tzshin/EjectionBuddy/ejectedbuddy.png

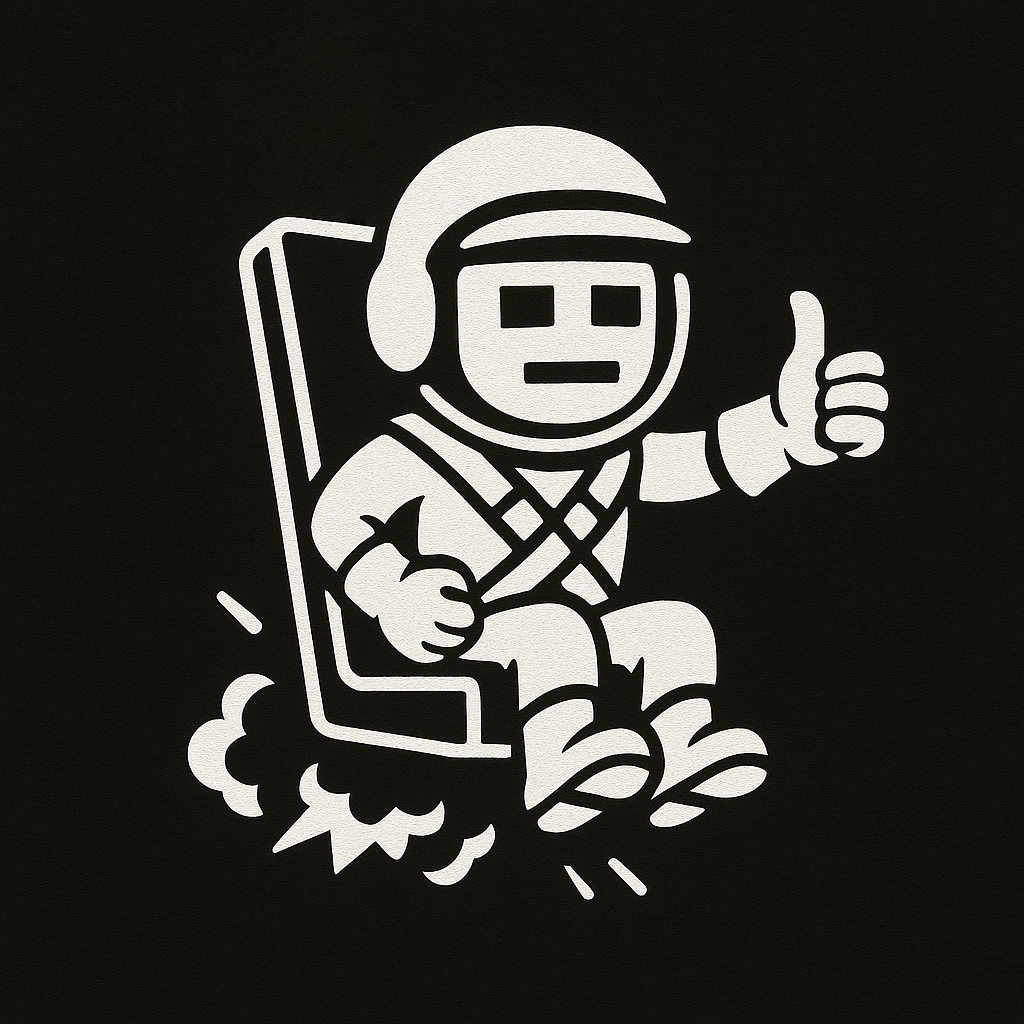
ejectedbuddy.png
