tzshin/EjectionBuddy/link.png

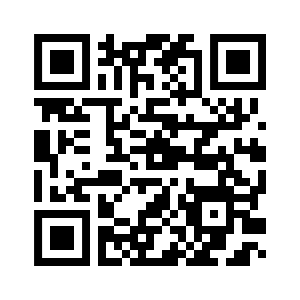
link.png
