tzshin/EjectionBuddy/kicad_libs/LM66200DRLR/LM66200DRLR.stp

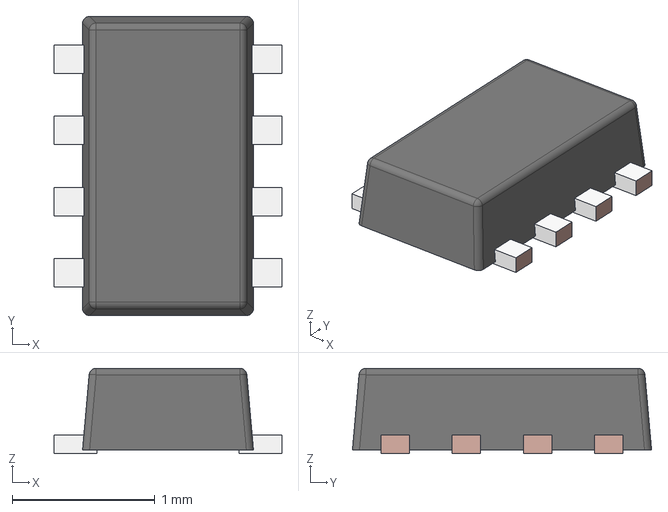
[picture p3: CAD file, 2025-04-03]
kicad_libs/LM66200DRLR/LM66200DRLR.stp
1.60 x 2.10 x 0.6 mm
FRAME-DRL0008A
BODY-SOT
