tzshin/EjectionBuddy/EjectionBuddy/EjectionBuddy.kicad_pcb

## KiCad design EjectionBuddy/EjectionBuddy.kicad_pcb (2025-04-20)

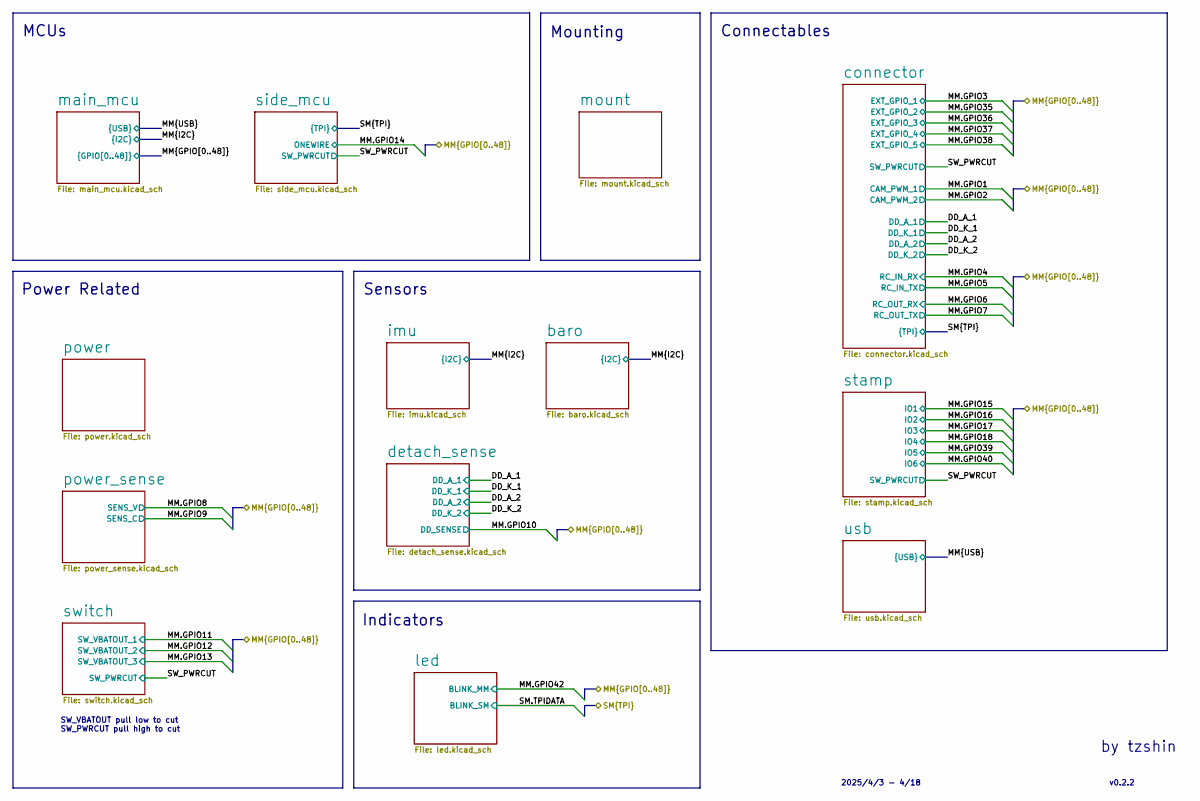
[picture p4: schematic EjectionBuddy.kicad_sch]

Notes on the sheet:
MCUs
Mounting
Sensors
v0.2.2
SW_VBATOUT pull low to cut SW_PWRCUT pull high to cut
2025/4/3 - 4/18
by tzshin
Connectables
Power Related
Indicators

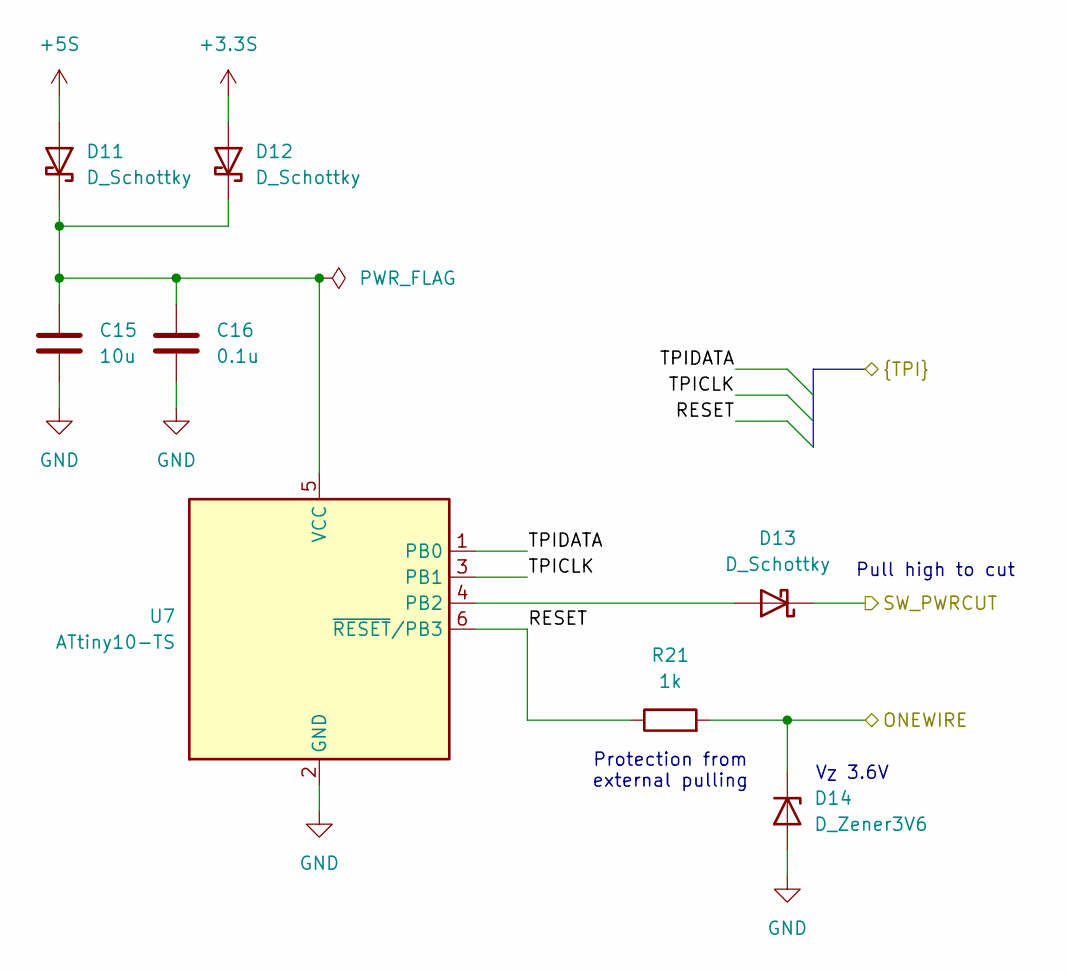
[picture p5: schematic side_mcu.kicad_sch]

Parts:
C15: 10u; C_0603_1608Metric
C16: 0.1u; C_0603_1608Metric
D11, D12, D13: D_Schottky; D_SOD-523
D14: D_Zener3V6; D_SOD-523
R21: 1k; R_0603_1608Metric
U7: ATtiny10-TS; SOT-23-6

Connections:
+3.3S: D12.2 (A); also elsewhere on the board
+5S: D11.2 (A); also elsewhere on the board
/MM.GPIO14: D14.1 (K), R21.2; also elsewhere on the board
/SM.RESET: R21.1, U7.6 (~RESET/PB3); also elsewhere on the board
/SM.TPICLK: U7.3 (PB1); also elsewhere on the board
/SM.TPIDATA: U7.1 (PB0); also elsewhere on the board
/SW_PWRCUT: D13.1 (K); also elsewhere on the board
GND: C15.2, C16.2, D14.2 (A), U7.2 (GND); also elsewhere on the board
unnamed: C15.1, C16.1, D11.1 (K), D12.1 (K), U7.5 (VCC)
unnamed: D13.2 (A), U7.4 (PB2)

Notes on the sheet:
Protection from external pulling
V_{Z} 3.6V
Pull high to cut

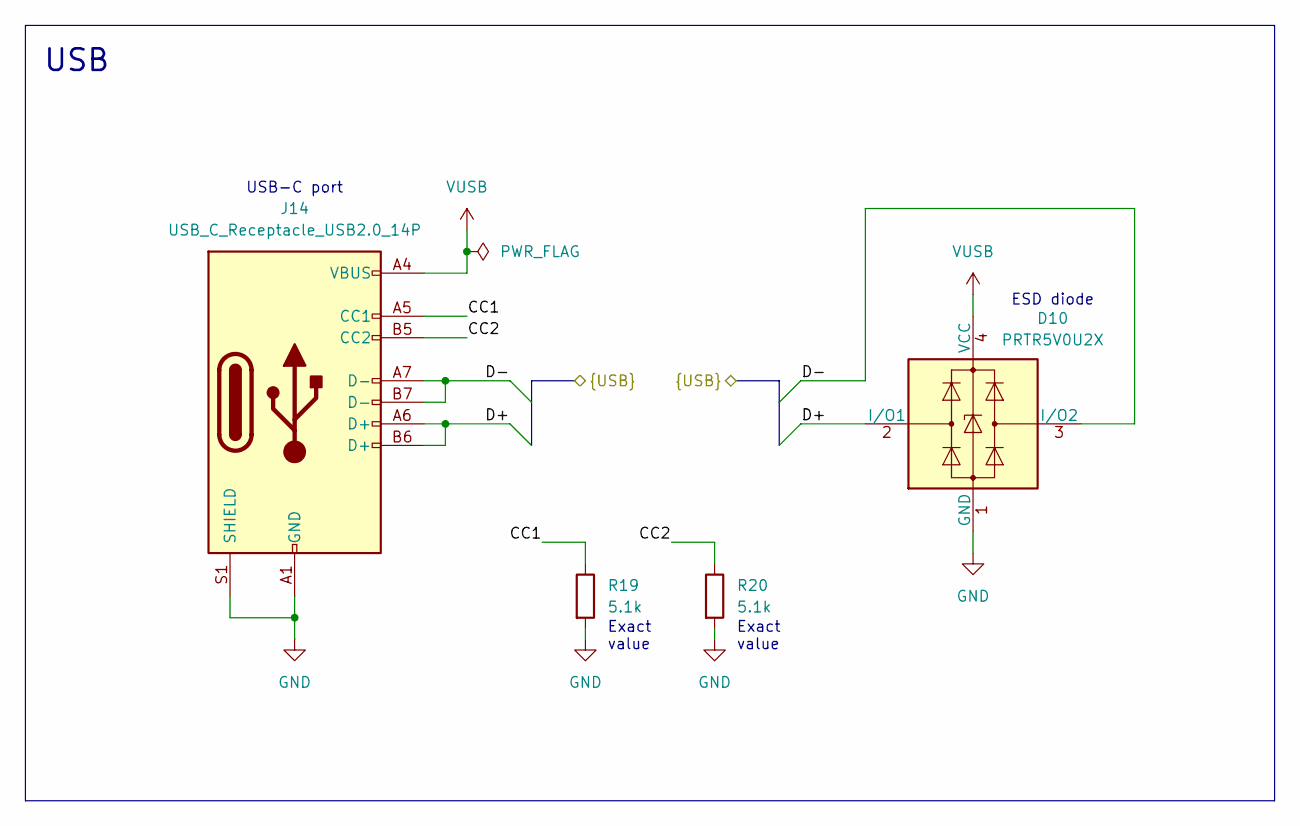
[picture p6: schematic usb.kicad_sch]

Parts:
D10: PRTR5V0U2X; SOT-143
J14: USB_C_Receptacle_USB2.0_14P; USB_C_Receptacle_HRO_TYPE-C-31-M-12
R19, R20: 5.1k; R_0603_1608Metric

Connections:
/MM.D+: D10.2 (I/O1), J14.A6 (D+), J14.B6 (D+); also elsewhere on the board
/MM.D-: D10.3 (I/O2), J14.A7 (D-), J14.B7 (D-); also elsewhere on the board
/usb/CC1: J14.A5 (CC1), R19.1
/usb/CC2: J14.B5 (CC2), R20.1
GND: D10.1 (GND), J14.A1 (GND), J14.A12 (GND), J14.B1 (GND), J14.B12 (GND), J14.S1 (SHIELD), R19.2, R20.2; also elsewhere on the board
VUSB: D10.4 (VCC), J14.A4 (VBUS), J14.A9 (VBUS), J14.B4 (VBUS), J14.B9 (VBUS); also elsewhere on the board

Notes on the sheet:
USB-C port
Exact value
USB
ESD diode

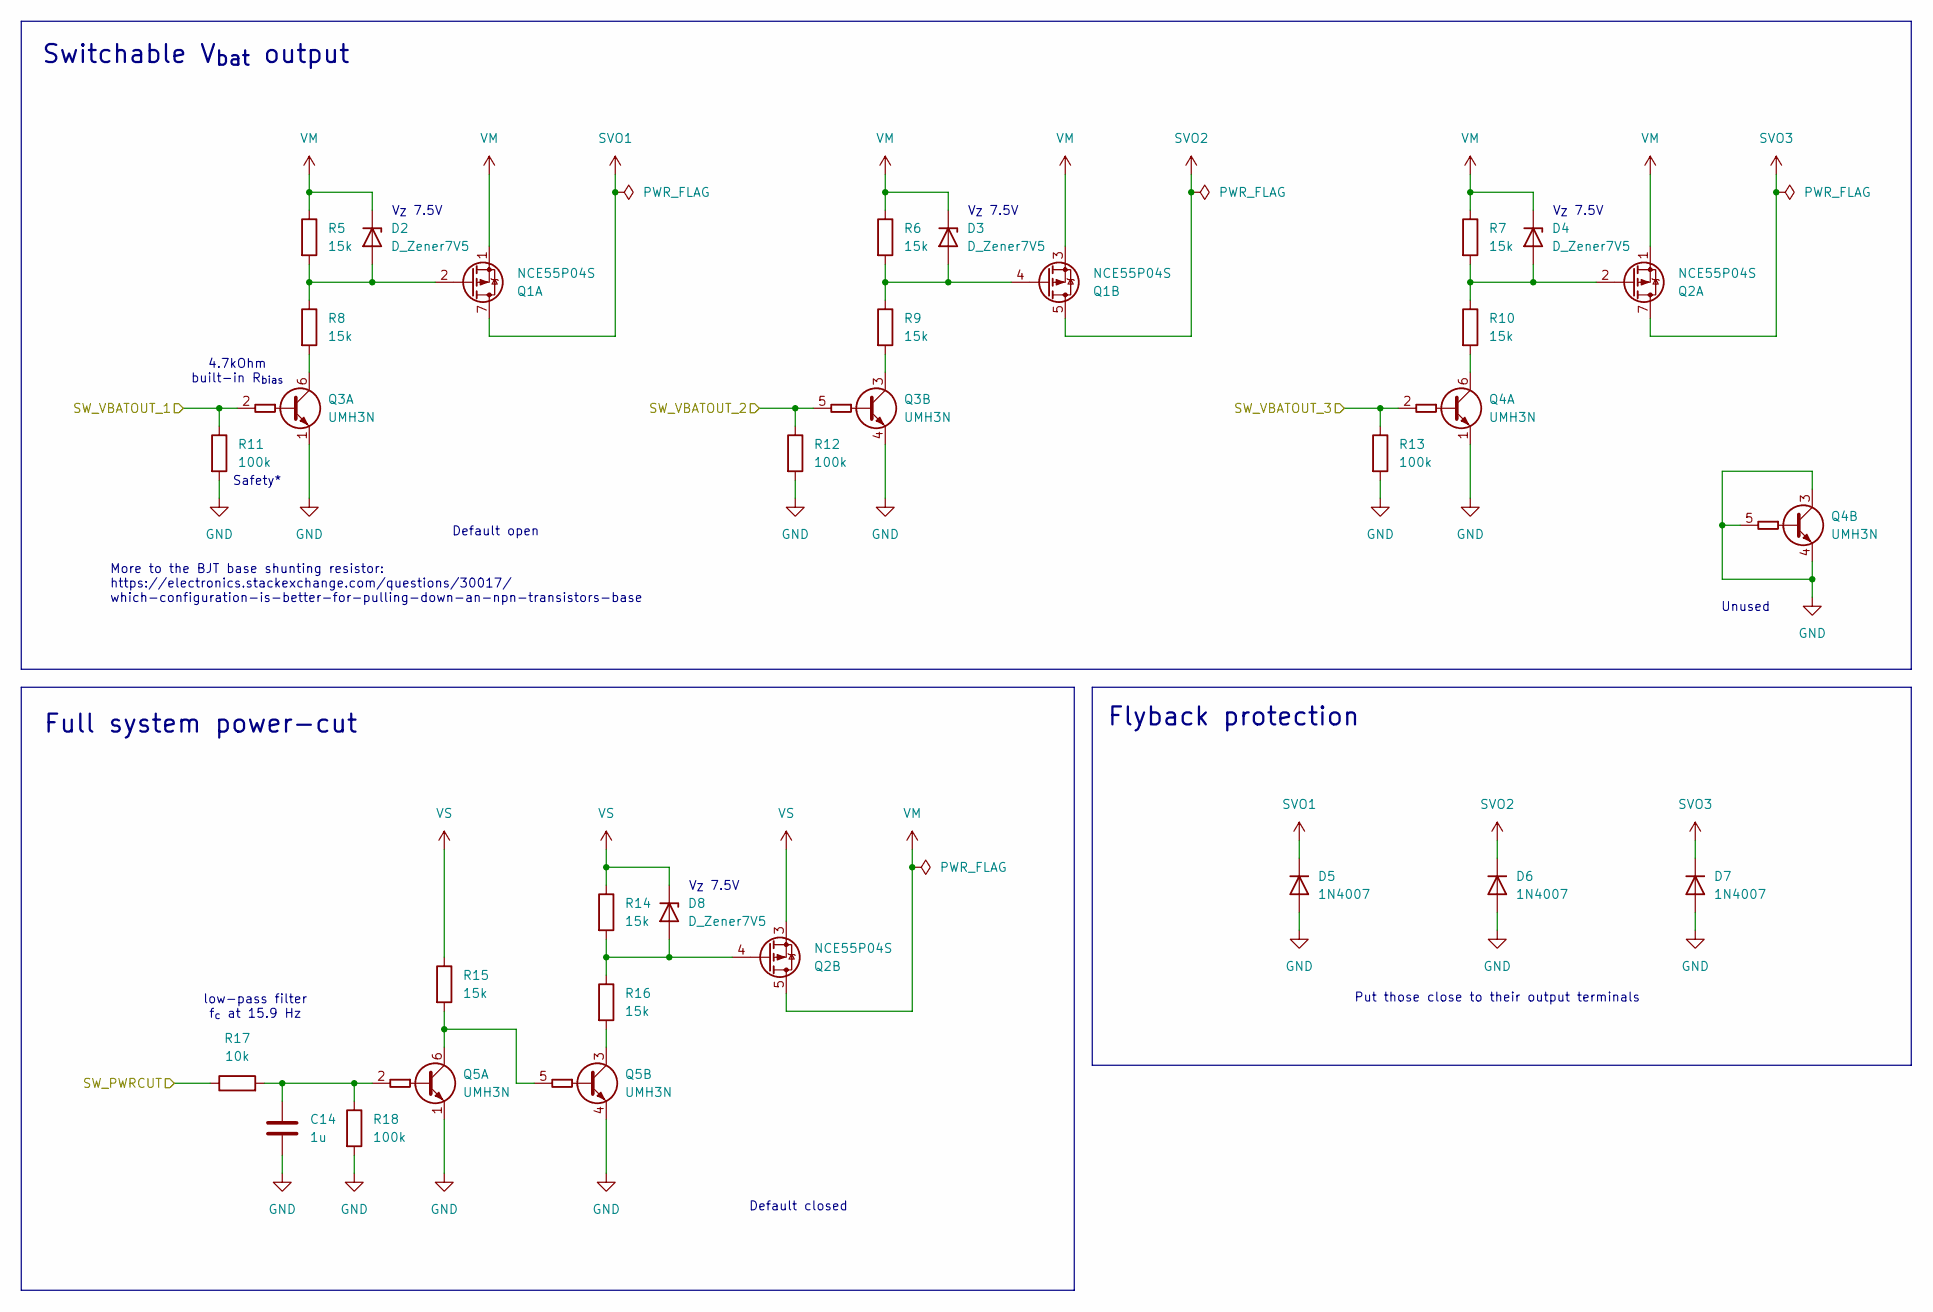
[picture p7: schematic switch.kicad_sch]

Parts:
C14: 1u; C_0603_1608Metric
D2, D3, D4, D8: D_Zener7V5; D_SOD-523
D5, D6, D7: 1N4007; Nexperia_CFP3_SOD-123W
Q1, Q2: NCE55P04S; SOP-8_3.9x4.9mm_P1.27mm
Q3, Q4, Q5: UMH3N; SOT-363_SC-70-6
R5, R6, R7, R8, R9, R10, R14, R15, R16: 15k; R_0603_1608Metric
R11, R12, R13, R18: 100k; R_0603_1608Metric
R17: 10k; R_0603_1608Metric

Connections:
/MM.GPIO11: Q3.2 (B1), R11.1; also elsewhere on the board
/MM.GPIO12: Q3.5 (B2), R12.1; also elsewhere on the board
/MM.GPIO13: Q4.2 (B1), R13.1; also elsewhere on the board
/SW_PWRCUT: R17.1; also elsewhere on the board
GND: C14.2, D5.2 (A), D6.2 (A), D7.2 (A), Q3.1 (E1), Q3.4 (E2), Q4.1 (E1), Q4.3 (C2), Q4.4 (E2), Q4.5 (B2), Q5.1 (E1), Q5.4 (E2), R11.2, R12.2, R13.2, R18.2; also elsewhere on the board
unnamed: D2.2 (A), Q1.2 (G1), R5.2, R8.1
unnamed: D3.2 (A), Q1.4 (G2), R6.2, R9.1
unnamed: D4.2 (A), Q2.2 (G1), R7.2, R10.1
unnamed: D8.2 (A), Q2.4 (G2), R14.2, R16.1
unnamed: Q3.6 (C1), R8.2
unnamed: Q3.3 (C2), R9.2
unnamed: Q4.6 (C1), R10.2
unnamed: C14.1, Q5.2 (B1), R17.2, R18.1
unnamed: Q5.5 (B2), Q5.6 (C1), R15.2
unnamed: Q5.3 (C2), R16.2
SVO1: D5.1 (K), Q1.7 (D1), Q1.8 (D1); also elsewhere on the board
SVO2: D6.1 (K), Q1.5 (D2), Q1.6 (D2); also elsewhere on the board
SVO3: D7.1 (K), Q2.7 (D1), Q2.8 (D1); also elsewhere on the board
VM: D2.1 (K), D3.1 (K), D4.1 (K), Q1.1 (S1), Q1.3 (S2), Q2.1 (S1), Q2.5 (D2), Q2.6 (D2), R5.1, R6.1, R7.1; also elsewhere on the board
VS: D8.1 (K), Q2.3 (S2), R14.1, R15.1; also elsewhere on the board

Notes on the sheet:
Safety*
V_{Z} 7.5V
Default open
Unused
More to the BJT base shunting resistor: https://electronics.stackexchange.com/questions/30017/ which-configuration-is-better-for-pulling-down-an-npn-transistors-base
4.7kOhm built-in R_{bias}
Put those close to their output terminals
Full system power-cut
Switchable V_{bat} output
Default closed
low-pass filter f_{c} at 15.9 Hz
Flyback protection

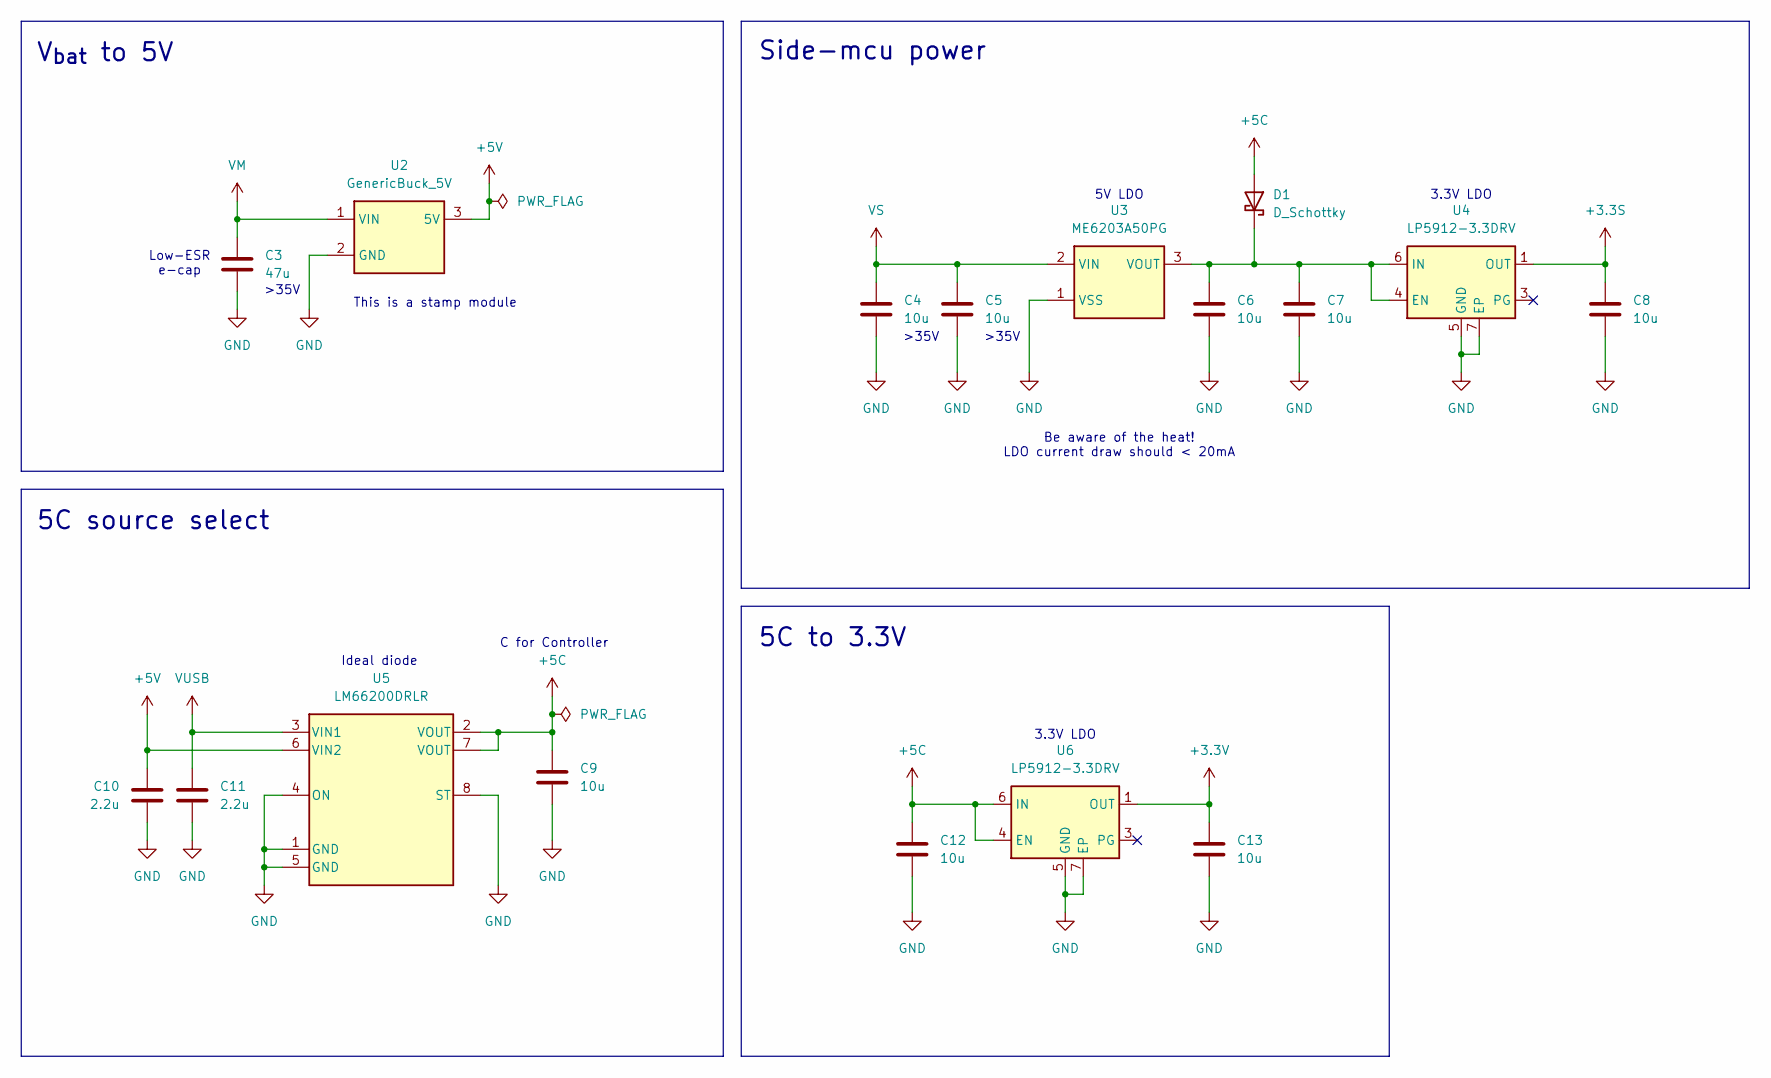
[picture p8: schematic power.kicad_sch]

Parts:
C3: 47u; CP_Elec_6.3x5.8
C4, C5, C6, C7, C8, C9, C12, C13: 10u; C_0603_1608Metric
C10, C11: 2.2u; C_0603_1608Metric
D1: D_Schottky; D_SOD-523
U2: GenericBuck_5V; MP4462BuckModule_TaoBao_20x17
U3: ME6203A50PG; SOT-89-3
U4, U6: LP5912-3.3DRV; WSON-6-1EP_2x2mm_P0.65mm_EP1x1.6mm_ThermalVias
U5: LM66200DRLR; SOT-583-8

Connections:
+3.3S: C8.1, U4.1 (OUT); also elsewhere on the board
+3.3V: C13.1, U6.1 (OUT); also elsewhere on the board
+5C: C9.1, C12.1, D1.2 (A), U5.2 (VOUT), U5.7 (VOUT), U6.4 (EN), U6.6 (IN); also elsewhere on the board
+5V: C10.1, U2.3 (5V), U5.6 (VIN2); also elsewhere on the board
GND: C3.2, C4.2, C5.2, C6.2, C7.2, C8.2, C9.2, C10.2, C11.2, C12.2, C13.2, U2.2 (GND), U3.1 (VSS), U4.5 (GND), U4.7 (EP), U5.1 (GND), U5.4 (ON), U5.5 (GND), U5.8 (ST), U6.5 (GND), U6.7 (EP); also elsewhere on the board
unnamed: C6.1, C7.1, D1.1 (K), U3.3 (VOUT), U4.4 (EN), U4.6 (IN)
VM: C3.1, U2.1 (VIN); also elsewhere on the board
VS: C4.1, C5.1, U3.2 (VIN); also elsewhere on the board
VUSB: C11.1, U5.3 (VIN1); also elsewhere on the board

Notes on the sheet:
>35V
Low-ESR e-cap
Side-mcu power
Be aware of the heat! LDO current draw should < 20mA
3.3V LDO
This is a stamp module
5C source select
C for Controller
5V LDO
Ideal diode
V_{bat} to 5V
5C to 3.3V

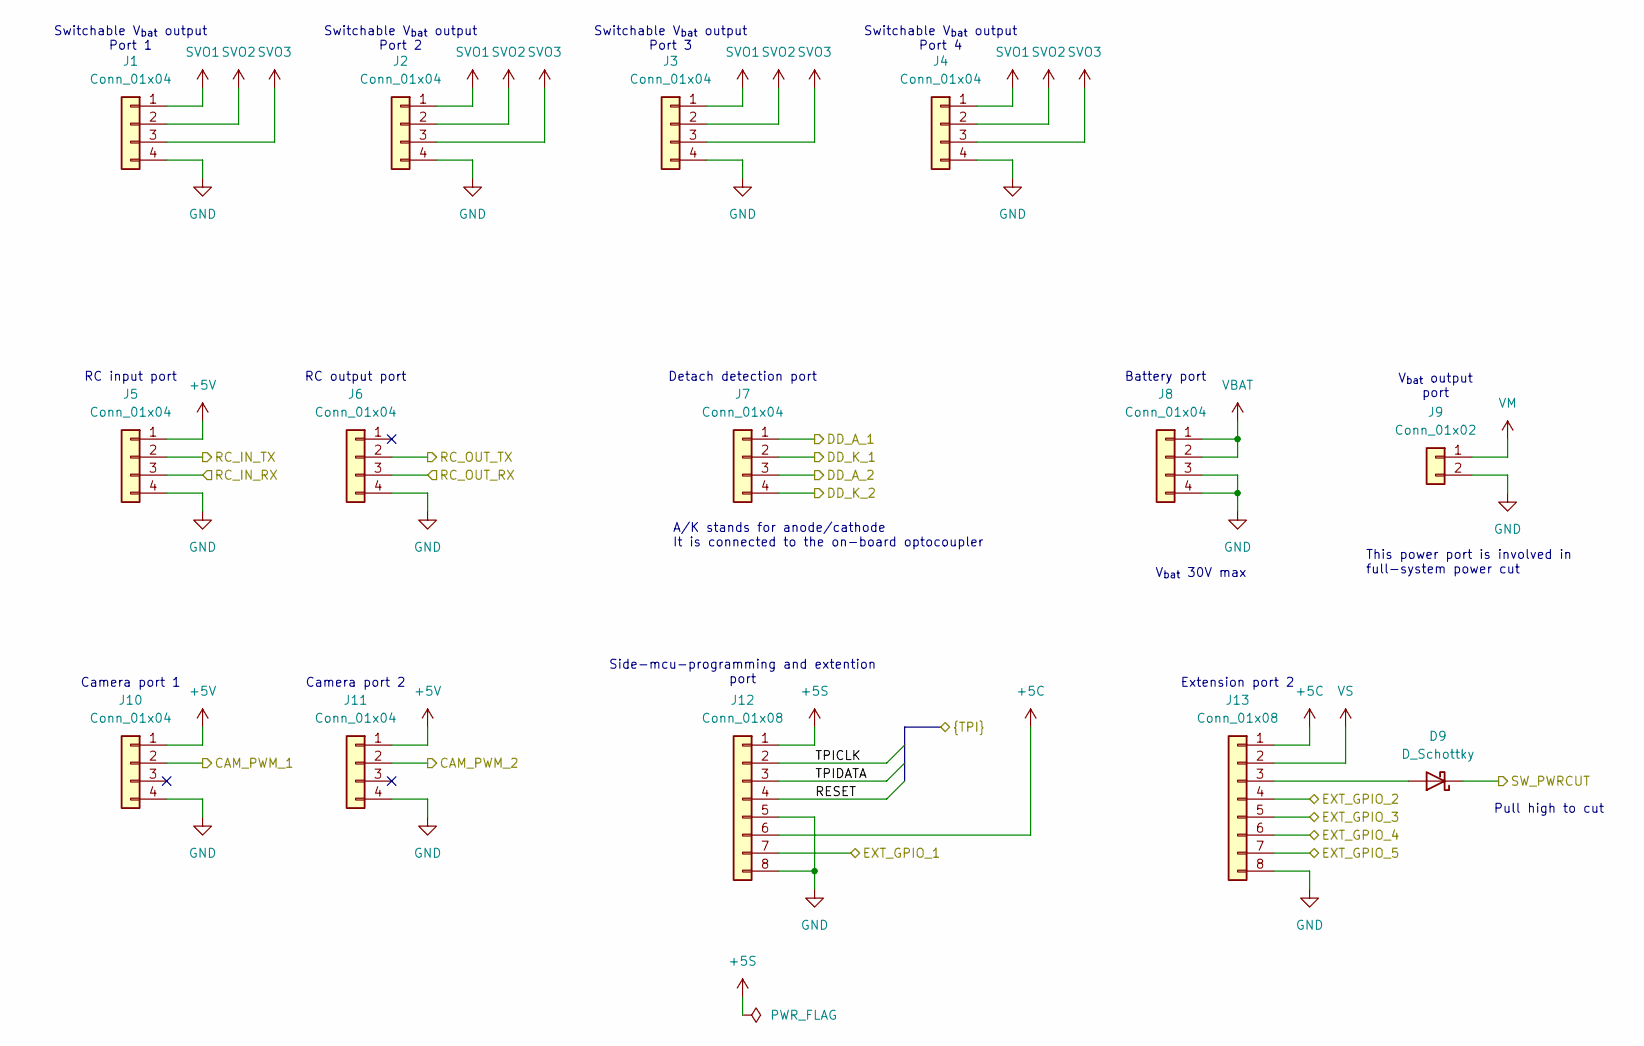
[picture p9: schematic connector.kicad_sch]

Parts:
D9: D_Schottky; D_SOD-523
J1, J2, J3, J4, J5, J6, J7, J8, J10, J11: Conn_01x04; JST_GH_SM04B-GHS-TB_1x04-1MP_P1.25mm_Horizontal
J9: Conn_01x02; JST_GH_SM02B-GHS-TB_1x02-1MP_P1.25mm_Horizontal
J12, J13: Conn_01x08; JST_GH_SM08B-GHS-TB_1x08-1MP_P1.25mm_Horizontal

Connections:
+5C: J12.6, J13.1; also elsewhere on the board
+5S: J12.1; also elsewhere on the board
+5V: J5.1, J10.1, J11.1; also elsewhere on the board
/DD_A_1: J7.1; also elsewhere on the board
/DD_A_2: J7.3; also elsewhere on the board
/DD_K_1: J7.2; also elsewhere on the board
/DD_K_2: J7.4; also elsewhere on the board
/MM.GPIO1: J10.2; also elsewhere on the board
/MM.GPIO2: J11.2; also elsewhere on the board
/MM.GPIO3: J12.7; also elsewhere on the board
/MM.GPIO4: J5.3; also elsewhere on the board
/MM.GPIO5: J5.2; also elsewhere on the board
/MM.GPIO6: J6.3; also elsewhere on the board
/MM.GPIO7: J6.2; also elsewhere on the board
/MM.GPIO35: J13.4; also elsewhere on the board
/MM.GPIO36: J13.5; also elsewhere on the board
/MM.GPIO37: J13.6; also elsewhere on the board
/MM.GPIO38: J13.7; also elsewhere on the board
/SM.RESET: J12.4; also elsewhere on the board
/SM.TPICLK: J12.2; also elsewhere on the board
/SM.TPIDATA: J12.3; also elsewhere on the board
/SW_PWRCUT: D9.1 (K); also elsewhere on the board
GND: J1.4, J2.4, J3.4, J4.4, J5.4, J6.4, J8.3, J8.4, J9.2, J10.4, J11.4, J12.5, J12.8, J13.8; also elsewhere on the board
unnamed: D9.2 (A), J13.3
SVO1: J1.1, J2.1, J3.1, J4.1; also elsewhere on the board
SVO2: J1.2, J2.2, J3.2, J4.2; also elsewhere on the board
SVO3: J1.3, J2.3, J3.3, J4.3; also elsewhere on the board
VBAT: J8.1, J8.2; also elsewhere on the board
VM: J9.1; also elsewhere on the board
VS: J13.2; also elsewhere on the board

Notes on the sheet:
Switchable V_{bat} output Port 3
Switchable V_{bat} output Port 1
Side-mcu-programming and extention port
RC output port
Pull high to cut
Camera port 2
Extension port 2
Detach detection port
Battery port
V_{bat} output port
RC input port
Switchable V_{bat} output Port 2
This power port is involved in full-system power cut
V_{bat} 30V max
A/K stands for anode/cathode It is connected to the on-board optocoupler
Switchable V_{bat} output Port 4
Camera port 1

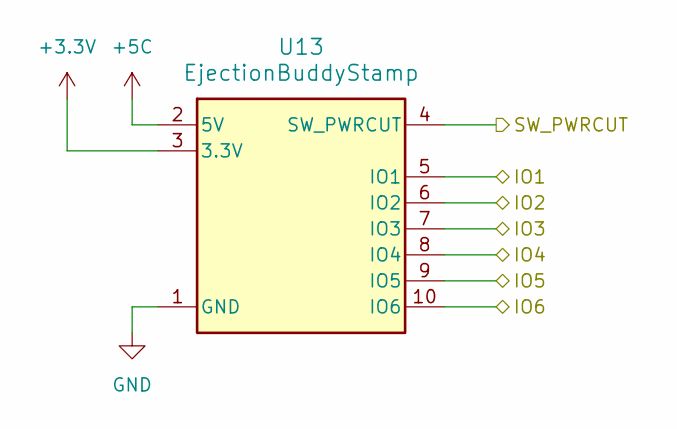
[picture p10: schematic stamp.kicad_sch]

Parts:
U13: EjectionBuddyStamp

Connections:
+3.3V: U13.3 (3.3V); also elsewhere on the board
+5C: U13.2 (5V); also elsewhere on the board
/MM.GPIO15: U13.5 (IO1); also elsewhere on the board
/MM.GPIO16: U13.6 (IO2); also elsewhere on the board
/MM.GPIO17: U13.7 (IO3); also elsewhere on the board
/MM.GPIO18: U13.8 (IO4); also elsewhere on the board
/MM.GPIO39: U13.9 (IO5); also elsewhere on the board
/MM.GPIO40: U13.10 (IO6); also elsewhere on the board
/SW_PWRCUT: U13.4 (SW_PWRCUT); also elsewhere on the board
GND: U13.1 (GND); also elsewhere on the board

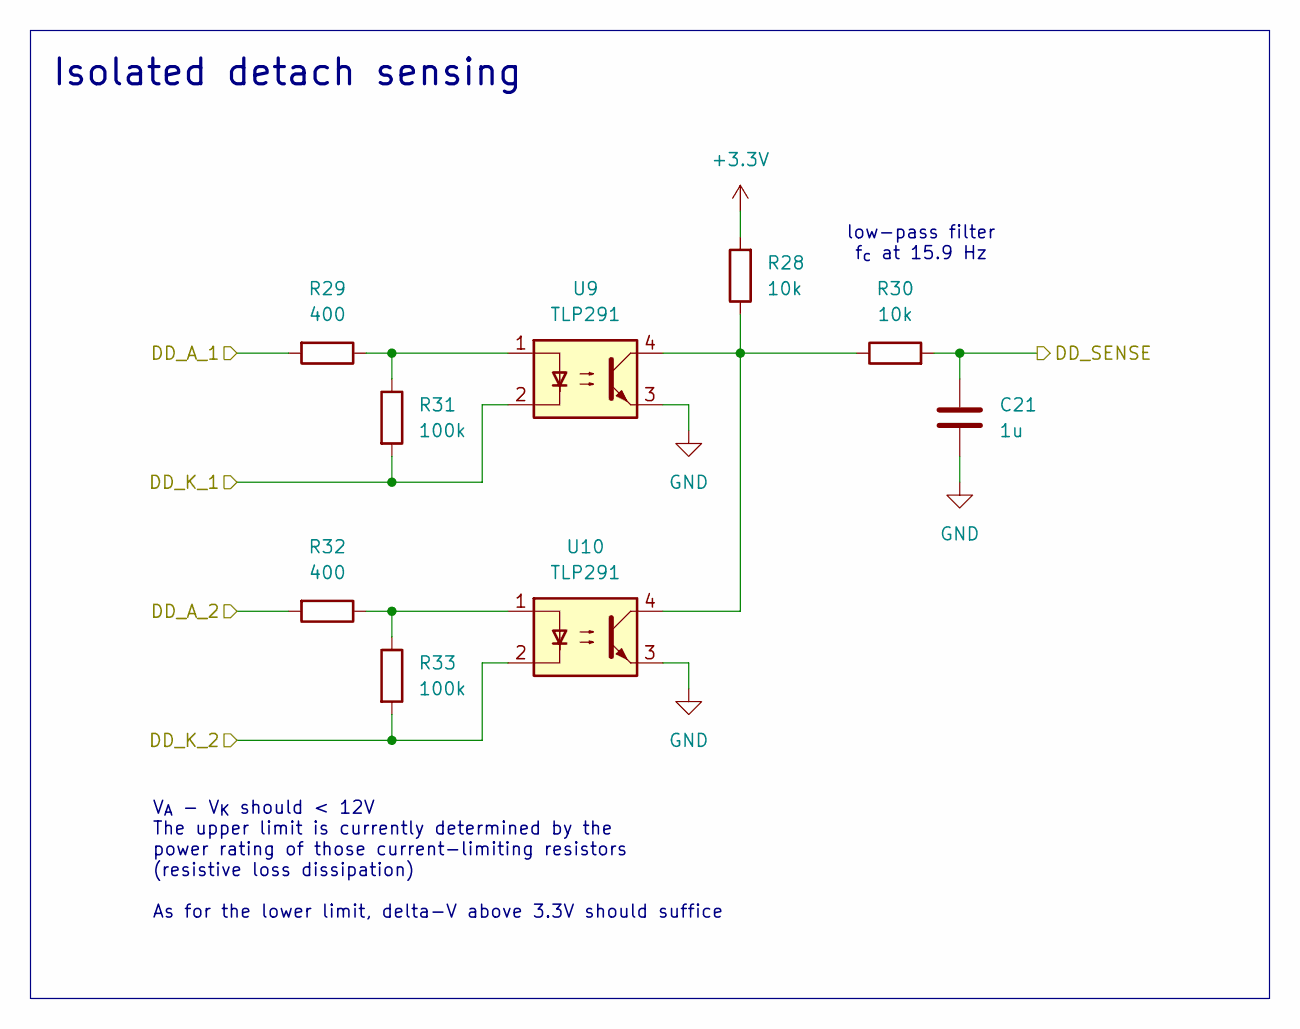
[picture p11: schematic detach_sense.kicad_sch]

Parts:
C21: 1u; C_0603_1608Metric
R28, R30: 10k; R_0603_1608Metric
R29, R32: 400; R_0603_1608Metric
R31, R33: 100k; R_0603_1608Metric
U9, U10: TLP291; SOIC-4_4.55x2.6mm_P1.27mm

Connections:
+3.3V: R28.2; also elsewhere on the board
/DD_A_1: R29.2; also elsewhere on the board
/DD_A_2: R32.2; also elsewhere on the board
/DD_K_1: R31.2, U9.2; also elsewhere on the board
/DD_K_2: R33.2, U10.2; also elsewhere on the board
/MM.GPIO10: C21.1, R30.2; also elsewhere on the board
GND: C21.2, U9.3, U10.3; also elsewhere on the board
unnamed: R28.1, R30.1, U9.4, U10.4
unnamed: R29.1, R31.1, U9.1
unnamed: R32.1, R33.1, U10.1

Notes on the sheet:
V_{A} - V_{K} should < 12V The upper limit is currently determined by the power rating of those current-limiting resistors (resistive loss dissipation) As for the lower limit, delta-V above 3.3V should suffice
Isolated detach sensing
low-pass filter f_{c} at 15.9 Hz

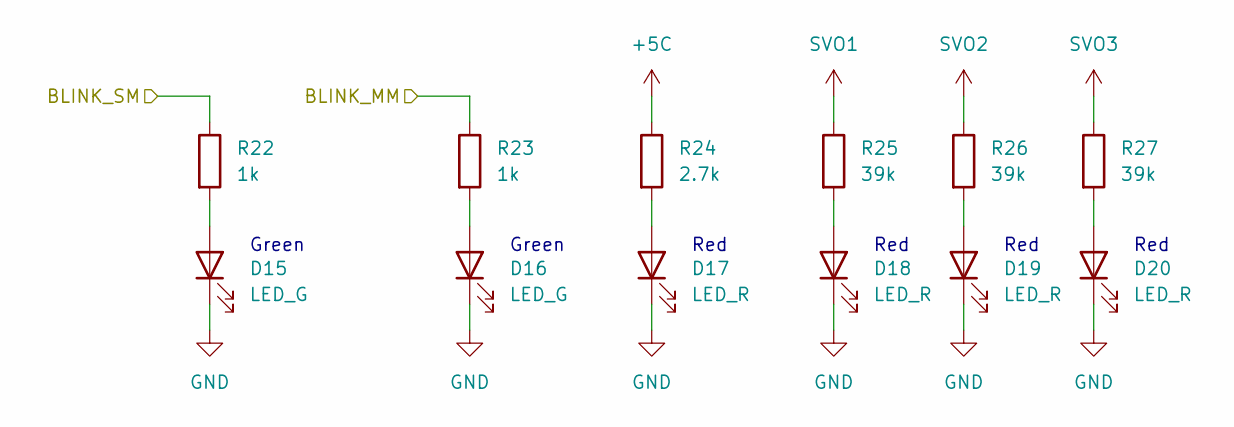
[picture p12: schematic led.kicad_sch]

Parts:
D15, D16: LED_G; LED_0603_1608Metric
D17, D18, D19, D20: LED_R; LED_0603_1608Metric
R22, R23: 1k; R_0603_1608Metric
R24: 2.7k; R_0603_1608Metric
R25, R26, R27: 39k; R_0603_1608Metric

Connections:
+5C: R24.1; also elsewhere on the board
/MM.GPIO42: R23.1; also elsewhere on the board
/SM.TPIDATA: R22.1; also elsewhere on the board
GND: D15.1 (K), D16.1 (K), D17.1 (K), D18.1 (K), D19.1 (K), D20.1 (K); also elsewhere on the board
unnamed: D15.2 (A), R22.2
unnamed: D16.2 (A), R23.2
unnamed: D17.2 (A), R24.2
unnamed: D18.2 (A), R25.2
unnamed: D19.2 (A), R26.2
unnamed: D20.2 (A), R27.2
SVO1: R25.1; also elsewhere on the board
SVO2: R26.1; also elsewhere on the board
SVO3: R27.1; also elsewhere on the board

Notes on the sheet:
Green
Red

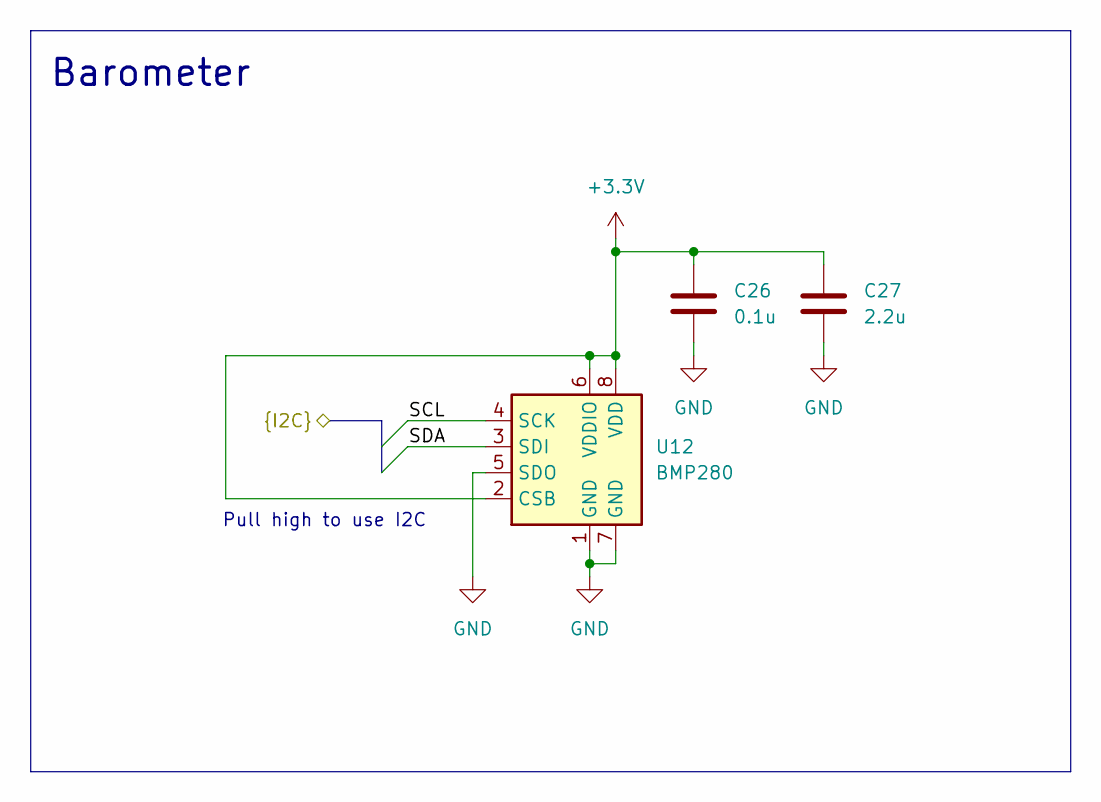
[picture p13: schematic baro.kicad_sch]

Parts:
C26: 0.1u; C_0603_1608Metric
C27: 2.2u; C_0603_1608Metric
U12: BMP280; Bosch_LGA-8_2x2.5mm_P0.65mm_ClockwisePinNumbering

Connections:
+3.3V: C26.1, C27.1, U12.2 (CSB), U12.6 (VDDIO), U12.8 (VDD); also elsewhere on the board
/MM.SCL: U12.4 (SCK); also elsewhere on the board
/MM.SDA: U12.3 (SDI); also elsewhere on the board
GND: C26.2, C27.2, U12.1 (GND), U12.5 (SDO), U12.7 (GND); also elsewhere on the board

Notes on the sheet:
Barometer
Pull high to use I2C

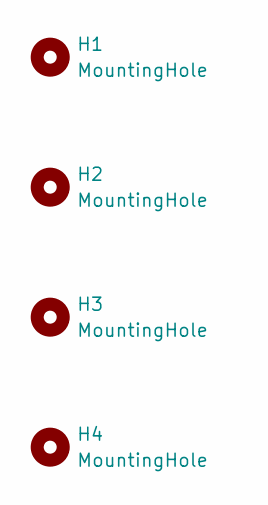
[picture p14: schematic mount.kicad_sch]

Parts:
H1, H2, H3, H4: MountingHole; HoleNoMask_4.3mm_M4

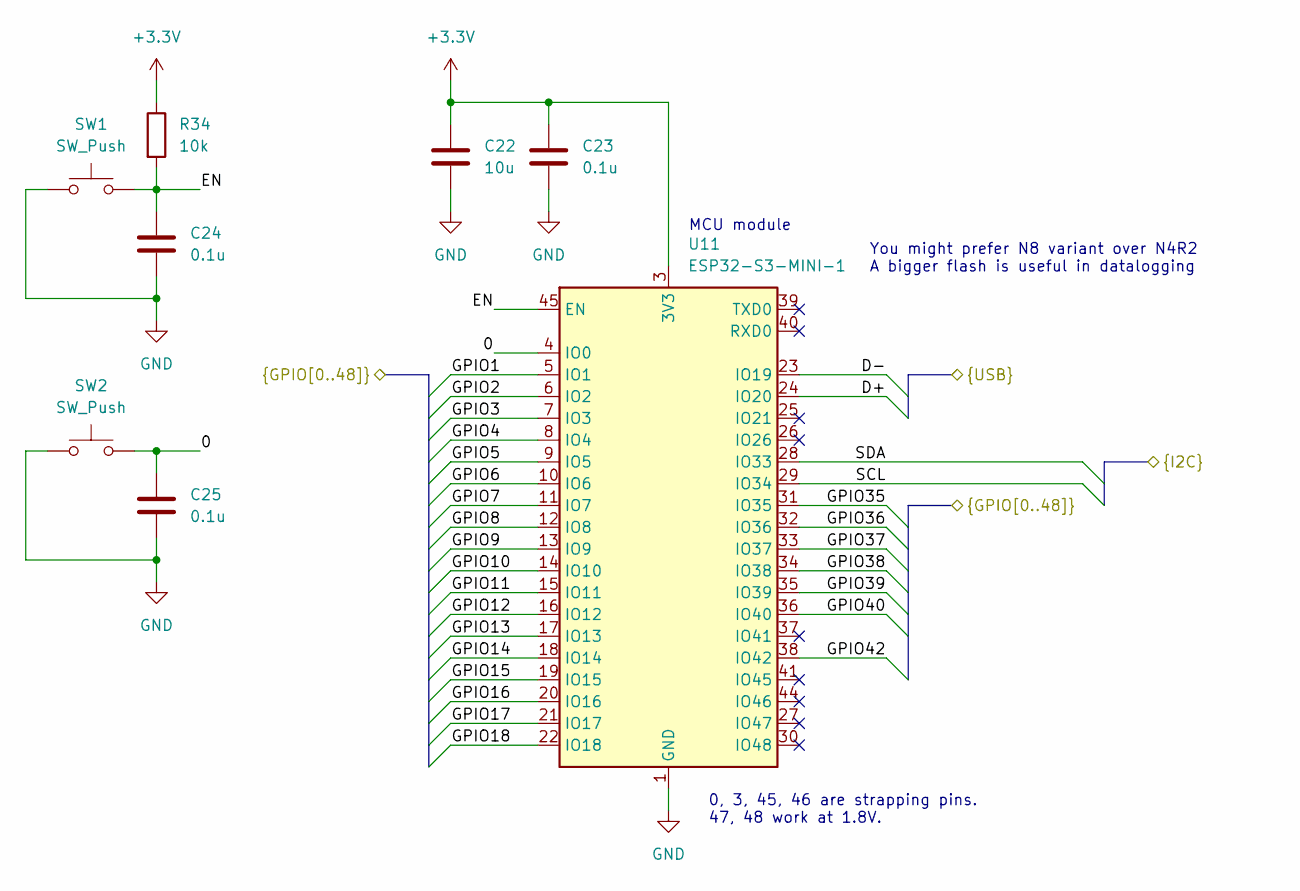
[picture p15: schematic main_mcu.kicad_sch]

Parts:
C22: 10u; C_0603_1608Metric
C23, C24, C25: 0.1u; C_0603_1608Metric
R34: 10k; R_0603_1608Metric
SW1, SW2: SW_Push; SW_SPST_PTS810
U11: ESP32-S3-MINI-1; ESP32-S2-MINI-1

Connections:
+3.3V: C22.1, C23.1, R34.1, U11.3 (3V3); also elsewhere on the board
/MM.D+: U11.24 (IO20); also elsewhere on the board
/MM.D-: U11.23 (IO19); also elsewhere on the board
/MM.GPIO1: U11.5 (IO1); also elsewhere on the board
/MM.GPIO2: U11.6 (IO2); also elsewhere on the board
/MM.GPIO3: U11.7 (IO3); also elsewhere on the board
/MM.GPIO4: U11.8 (IO4); also elsewhere on the board
/MM.GPIO5: U11.9 (IO5); also elsewhere on the board
/MM.GPIO6: U11.10 (IO6); also elsewhere on the board
/MM.GPIO7: U11.11 (IO7); also elsewhere on the board
/MM.GPIO8: U11.12 (IO8); also elsewhere on the board
/MM.GPIO9: U11.13 (IO9); also elsewhere on the board
/MM.GPIO10: U11.14 (IO10); also elsewhere on the board
/MM.GPIO11: U11.15 (IO11); also elsewhere on the board
/MM.GPIO12: U11.16 (IO12); also elsewhere on the board
/MM.GPIO13: U11.17 (IO13); also elsewhere on the board
/MM.GPIO14: U11.18 (IO14); also elsewhere on the board
/MM.GPIO15: U11.19 (IO15); also elsewhere on the board
/MM.GPIO16: U11.20 (IO16); also elsewhere on the board
/MM.GPIO17: U11.21 (IO17); also elsewhere on the board
/MM.GPIO18: U11.22 (IO18); also elsewhere on the board
/MM.GPIO35: U11.31 (IO35); also elsewhere on the board
/MM.GPIO36: U11.32 (IO36); also elsewhere on the board
/MM.GPIO37: U11.33 (IO37); also elsewhere on the board
/MM.GPIO38: U11.34 (IO38); also elsewhere on the board
/MM.GPIO39: U11.35 (IO39); also elsewhere on the board
/MM.GPIO40: U11.36 (IO40); also elsewhere on the board
/MM.GPIO42: U11.38 (IO42); also elsewhere on the board
/MM.SCL: U11.29 (IO34); also elsewhere on the board
/MM.SDA: U11.28 (IO33); also elsewhere on the board
/main_mcu/0: C25.1, SW2.2, U11.4 (IO0)
/main_mcu/EN: C24.1, R34.2, SW1.2, U11.45 (EN)
GND: C22.2, C23.2, C24.2, C25.2, SW1.1, SW2.1, U11.1 (GND), U11.2 (GND), U11.42 (GND), U11.43 (GND), U11.46 (GND), U11.47 (GND), U11.48 (GND), U11.49 (GND), U11.50 (GND), U11.51 (GND), U11.52 (GND), U11.53 (GND), U11.54 (GND), U11.55 (GND), U11.56 (GND), U11.57 (GND), U11.58 (GND), U11.59 (GND), U11.60 (GND), U11.61 (GND), U11.62 (GND), U11.63 (GND), U11.64 (GND), U11.65 (GND); also elsewhere on the board

Notes on the sheet:
You might prefer N8 variant over N4R2 A bigger flash is useful in datalogging
MCU module
0, 3, 45, 46 are strapping pins. 47, 48 work at 1.8V.

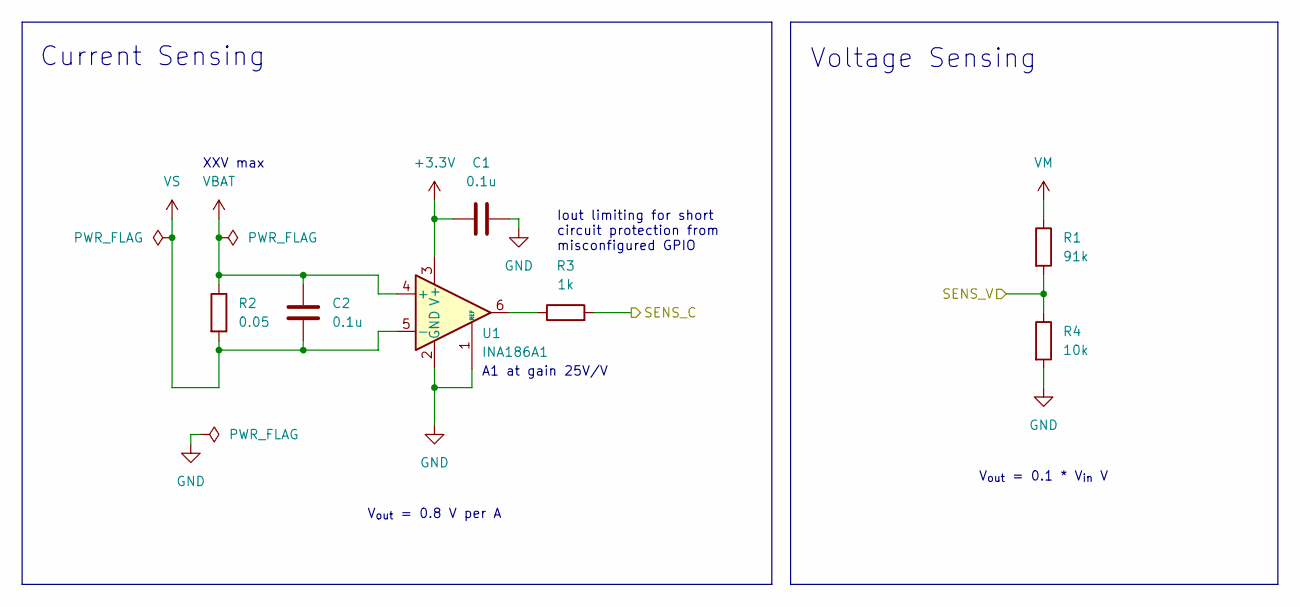
[picture p16: schematic power_sense.kicad_sch]

Parts:
C1, C2: 0.1u; C_0603_1608Metric
R1: 91k; R_0603_1608Metric
R2: 0.05; R_0805_2012Metric
R3: 1k; R_0603_1608Metric
R4: 10k; R_0603_1608Metric
U1: INA186A1; SOT-363_SC-70-6

Connections:
+3.3V: C1.1, U1.3 (V+); also elsewhere on the board
/MM.GPIO8: R1.2, R4.1; also elsewhere on the board
/MM.GPIO9: R3.2; also elsewhere on the board
GND: C1.2, R4.2, U1.1 (REF), U1.2 (GND); also elsewhere on the board
unnamed: R3.1, U1.6
VBAT: C2.1, R2.1, U1.4 (+); also elsewhere on the board
VM: R1.1; also elsewhere on the board
VS: C2.2, R2.2, U1.5 (-); also elsewhere on the board

Notes on the sheet:
Iout limiting for short circuit protection from misconfigured GPIO
V_{out} = 0.1 * V_{in} V
Current Sensing
V_{out} = 0.8 V per A
A1 at gain 25V/V
Voltage Sensing
XXV max
