tzshin/EjectionBuddy/EjectionBuddy/EjectionBuddy.kicad_pcb

## KiCad design EjectionBuddy/EjectionBuddy.kicad_pcb (continued)

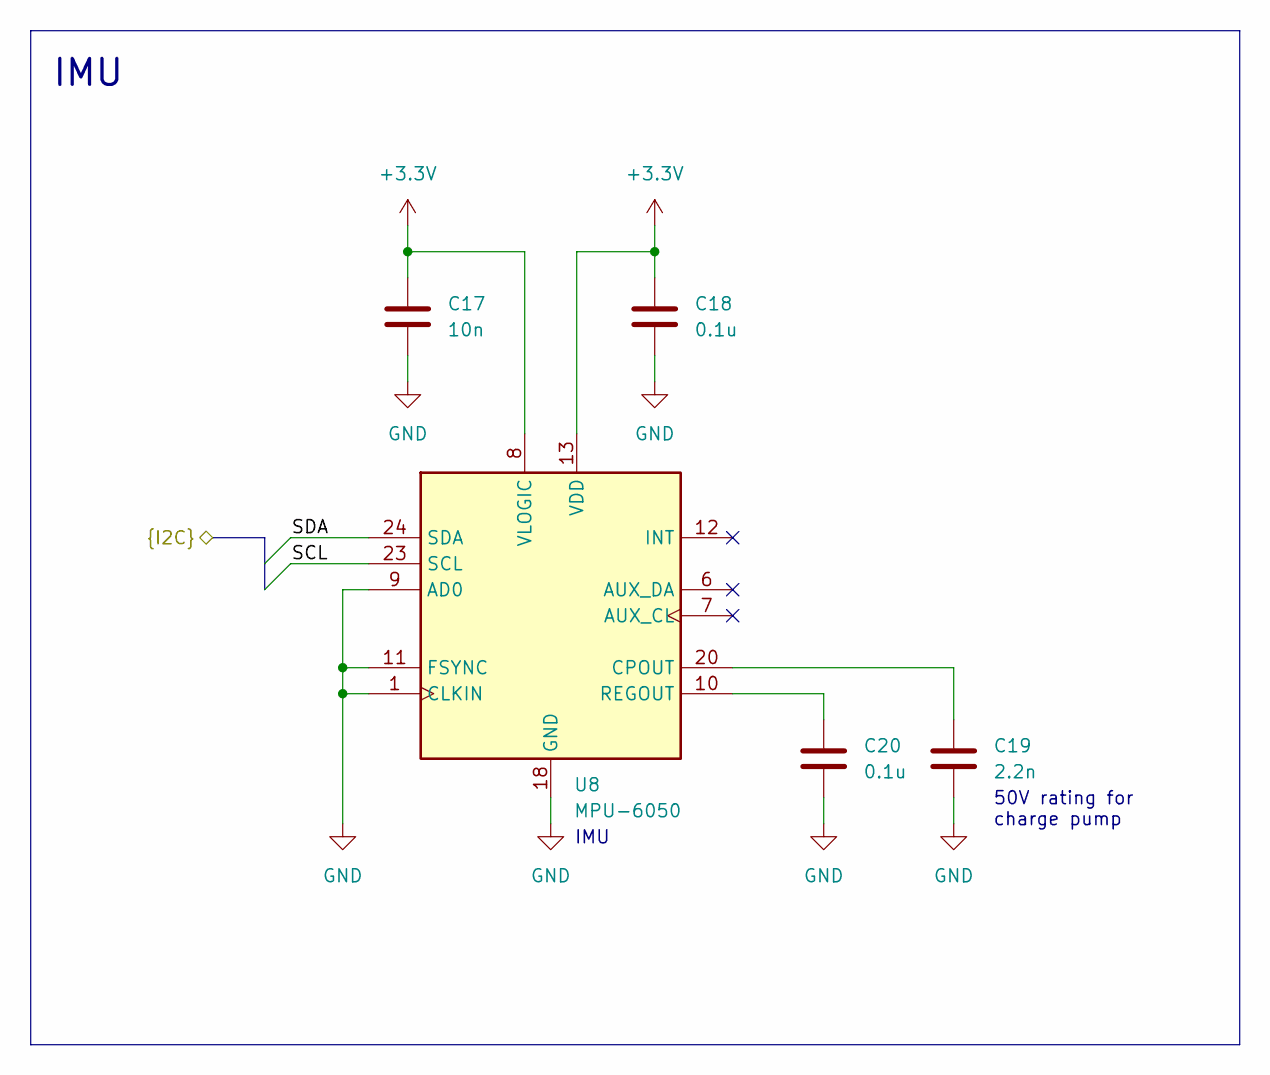
[picture p17: schematic imu.kicad_sch]

Parts:
C17: 10n; C_0603_1608Metric
C18, C20: 0.1u; C_0603_1608Metric
C19: 2.2n; C_0603_1608Metric
U8: MPU-6050; InvenSense_QFN-24_4x4mm_P0.5mm

Connections:
+3.3V: C17.1, C18.1, U8.8 (VLOGIC), U8.13 (VDD); also elsewhere on the board
/MM.SCL: U8.23 (SCL); also elsewhere on the board
/MM.SDA: U8.24 (SDA); also elsewhere on the board
GND: C17.2, C18.2, C19.2, C20.2, U8.1 (CLKIN), U8.9 (AD0), U8.11 (FSYNC), U8.18 (GND); also elsewhere on the board
unnamed: C19.1, U8.20 (CPOUT)
unnamed: C20.1, U8.10 (REGOUT)

Notes on the sheet:
IMU
50V rating for charge pump

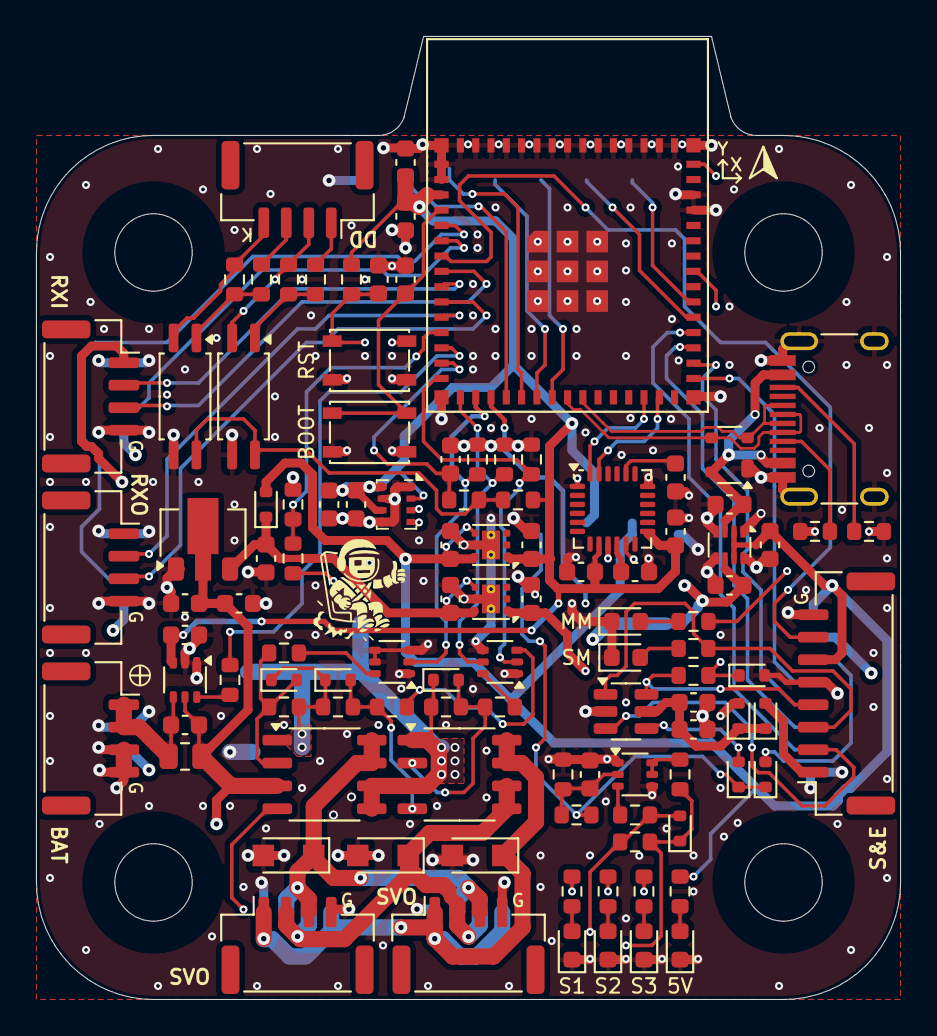
[picture p18: board EjectionBuddy.kicad_pcb from above]

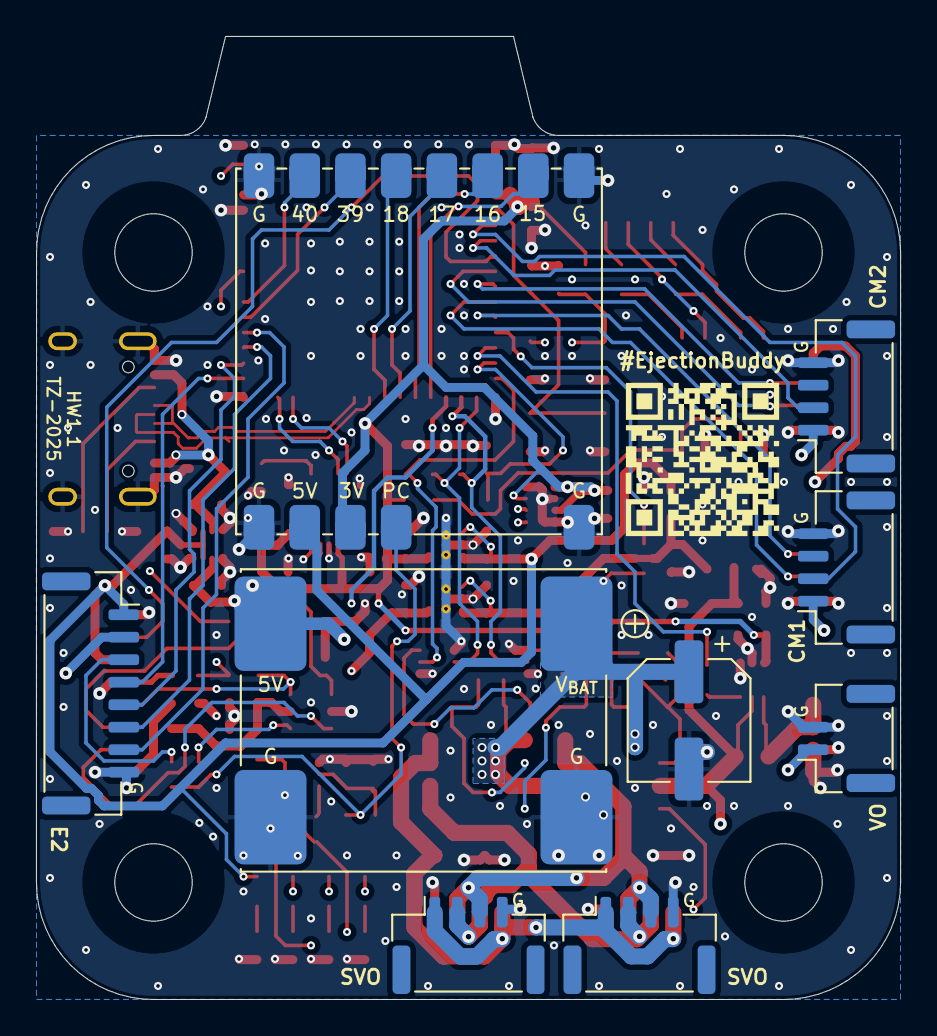
[picture p19: board EjectionBuddy.kicad_pcb from below]

Board: 4 copper layers, 48.0 x 53.5 mm, 119 parts (9 on the bottom side), 80 nets.
