tzshin/EjectionBuddy/(commit log)

2025-04-03 Schematic half finished, a second MCU waiting to be implemented
    [EjectionBuddy.kicad_pcb, EjectionBuddy.kicad_sch, LM66200DRLR.stp, connector.kicad_sch, mount.kicad_sch, power.kicad_sch, power_sense.kicad_sch, sense.kicad_sch]
2025-04-04 More work on the side-mcu, ongoing
    [EjectionBuddy.kicad_sch, connect.kicad_sch, connecter.kicad_sch, power.kicad_sch, sense.kicad_sch, side_mcu.kicad_sch, switch.kicad_sch]
2025-04-13 Finished! QR and instruction pending
    [EjectionBuddy.kicad_pcb, EjectionBuddy.kicad_sch, baro.kicad_sch, connecter.kicad_sch, detach_sense.kicad_sch, imu.kicad_sch, isolate.kicad_sch, led.kicad_sch]
2025-04-13 Slight improvements on routing and schematic
    [EjectionBuddy.kicad_pcb, main_mcu.kicad_sch, power_sense.kicad_sch, side_mcu.kicad_sch, switch.kicad_sch]
2025-04-18 Side-mcu stm -> attiny, with improvements here and there
    [EjectionBuddy.kicad_pcb, EjectionBuddy.kicad_sch, baro.kicad_sch, connecter.kicad_sch, detach_sense.kicad_sch, imu.kicad_sch, led.kicad_sch, main_mcu.kicad_sch]
2025-04-18 Prodection version hw1.0 finished, with tidy-ups and bug-fixes
    [EjectionBuddy.kicad_pcb, EjectionBuddy.kicad_sch, baro.kicad_sch, connecter.kicad_sch, detach_sense.kicad_sch, imu.kicad_sch, led.kicad_sch, main_mcu.kicad_sch]
2025-04-18 Fix the e-cap footprint, we'll keep the 1.0
    [EjectionBuddy.kicad_pcb]
2025-04-18 Add Vbat voltage limit warning to schematic
    [connecter.kicad_sch, side_mcu.kicad_sch, switch.kicad_sch]
2025-04-18 Untrack sch renaming poop and renamed connecter.sch to connector.sch
    [EjectionBuddy.kicad_sch, connect.kicad_sch, connecter.kicad_sch, connector.kicad_sch, isolate.kicad_sch, main_mcu.kicad_sch, optoisolate.kicad_sch, pwr_sense.kicad_sch]
2025-04-20 Fixed a FATAL imu wiring fault, CPOUT
    [EjectionBuddy.kicad_pcb, EjectionBuddy.kicad_sch, imu.kicad_sch, side_mcu.kicad_sch, switch.kicad_sch]
